Skb2120/Phase-1-project/report/prototype-p_1.jpg

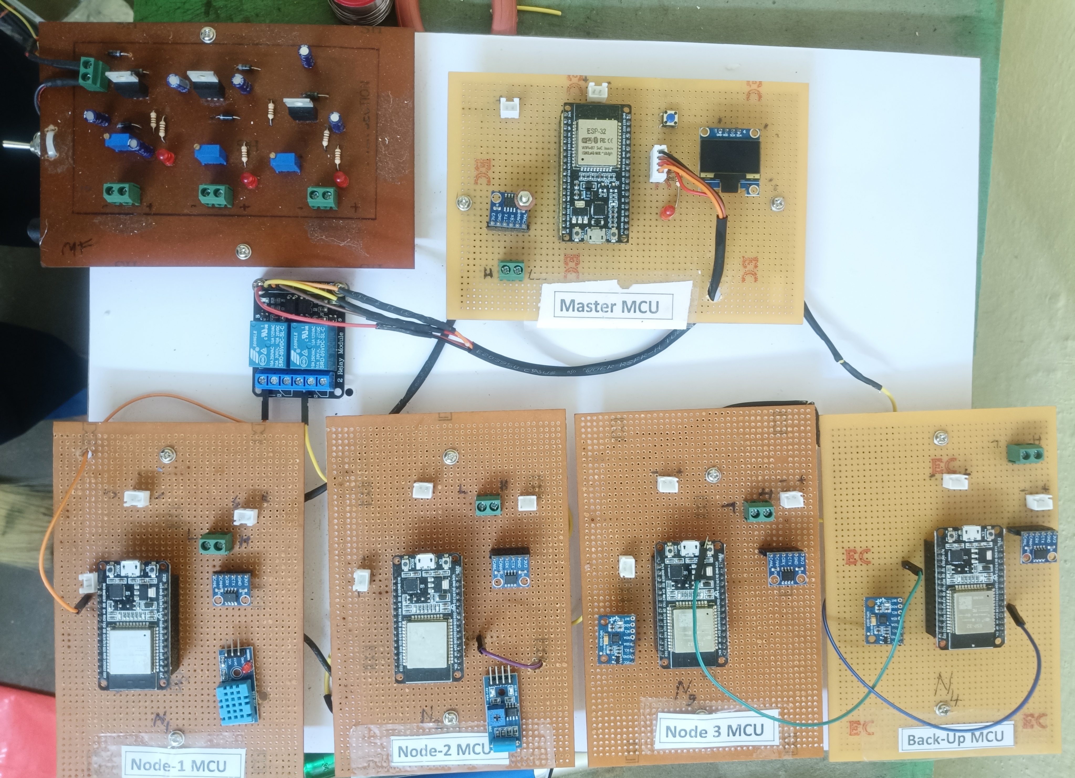
report/prototype-p_1.jpg
