Skb2120/Phase-1-project/report/report fornt page format.docx

CAN-Based Multi-Node ESP32 System for Fault Detection and Autonomous Task Reallocation to a Backup Node with IoT Dashboard Monitoring

Phase - 1 Project Report

Submitted by

Sarathkumar B (411725401001)

in partial fulfillment for the award of the degree of

MASTERS OF ENGINEERING IN

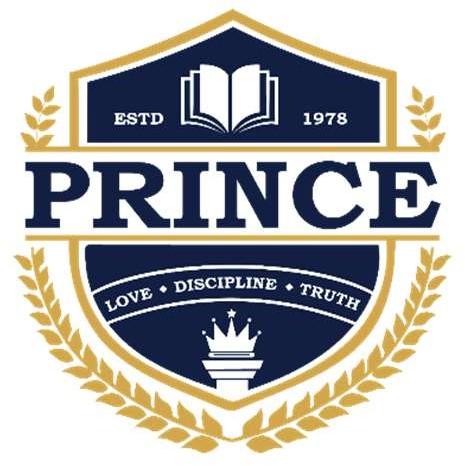
[picture p2: figure]

APPLIED ELECTRONICS

PRINCE SHRI VENKATESHWARA PADMAVATHY ENGINEERING COLLEGE

[AN AUTONOMOUS INSTITUTION], PONMAR, CHENNAI-127

ANNA UNIVERSITY: CHENNAI - 600025

OCTERBER 2026

BONAFIDE CERTIFICATE

Certified that this Phase-1 Project report “CAN-Based Multi-Node ESP32 System for Fault Detection and Autonomous Task Reallocation to a Backup Node with IoT Dashboard Monitoring” is the bonafide work of “Sarathkumar B (411725401001)” who carried out the project under my supervision.

SIGNATURE | SIGNATURE
Dr. K.K. SENTHILKUMAR, M.E., Ph.D., HEAD OF THE DEPARTMENT PROFESSOR Department of ECE, Prince Shri Venkateshwara Padmavathy Engineering College, Ponmar, Chennai- 600 127. | G.VIJAYALAKSHMI , M.E., PROJECT COORDINATOR ASSISTANT PROFESSOR Department of ECE, Prince Shri Venkateshwara Padmavathy EngineeringCollege, Ponmar, Chennai- 600 127.

Submitted for the project Viva-Voce examination held on

INTERNAL EXAMINER EXTERNAL EXAMINER

ACKNOWLEDGEMENT

We express our deep gratitude to our honorable Chairman Dr. K. VASUDEVAN M.A., M.Phil., Ph.D. for rending the technical staffs in completing this project.

We convey our sincere gratitude to our honorable Vice Chairman, Dr. V. VISHNU KARTHIK, M.D.,MBBS for his keen interest in our studies and the facilities offered in the premier institution.

We thank our Dean Dr. V. MAHALAKSHMI, ME., Ph.D., for her valuable guidance and encouragement in all our efforts throughout this course.

We thank our Principal Dr. G. INDIRA, M.E., Ph.D., for her valuable guidance and encouragement in all our efforts throughout this course.

We convey our sincere gratitude to our honorable Head of the Department, coordinator, Dr. K.K. SENTHILKUMAR, M.E., Ph.D., for complete support and constant encouragement without whom this project would not achieved fruition.

We would thank our coordinator, G.VIJAYALAKSHMI, M.E., ASSISTANT PROFESSOR for her constant, encouragement and technical advice.

We also express our deep gratitude to all other faculty members and Lab assistants for their moral support rendered to us.

We could like to express our sincere gratitude to all our family members and friends for their loving support and encouragement.

ABSTRACT

The proposed project presents a CAN communication-based multi-node ESP32 system for fault detection and autonomous task reallocation to a backup node with IoT dashboard monitoring. The system consists of a Master ESP32 and four sensor nodes interconnected through a Controller Area Network (CAN) bus. Node 1 monitors temperature and humidity using a DHT11 sensor, Node 2 detects vibration, and Node 3 performs motion monitoring using an MPU6050 sensor. Node 4 is designed as a universal backup node equipped with a DHT11 sensor, a vibration sensor, and an MPU6050 sensor to support the monitoring tasks of the primary nodes.

The Master ESP32 continuously monitors node health through heartbeat messages and identifies failures based on predefined timeout conditions. When a primary node becomes unavailable, the Master initiates task reassignment to the corresponding backup sensor on Node 4. This mechanism aims to reduce monitoring interruptions and improve system reliability. Sensor readings, node status, CAN communication information, fault events, and backup activation details are transmitted from the Master ESP32 to a cloud database using Wi-Fi and HTTP/HTTPS communication. A React.js web dashboard integrated with Supabase provides centralized visualization of sensor data, node health, fault detection, and recovery events.

The proposed system combines distributed embedded communication, autonomous fault management, sensor redundancy, and cloud-based monitoring in a unified architecture. The prototype is intended to demonstrate the feasibility of dynamic backup task allocation in embedded sensor networks.

Keywords: ESP32, CAN Bus, Fault Detection, Task Reallocation, Universal Backup Node, Embedded Systems, IoT Dashboard, Supabase.

TABLE OF CONTENTS

CHAPTER NO | TABLE OF CONTENTS | PAGE NO
| ABSTRACT | III
| TABLE OF CONTENTS | IV
| LIST OF FIGURE | VI
| LIST OF ABBREVIATIONS AND SYMBOLS | VII
1 | 1.1 Introduction | 1
| 1.2 Objective | 2
2 | Literature Survey | 4
3 | 3.1 Working Principle | 8
| 3.2 System Design | 10
| 3.3 PCB Design Of Power Section | 11
4 | 4.1 Hardware And Software Implementation | 14
| 4.1.1 ESP32 Development Board | 14
| 4.1.2 SN65HVD230 CAN Transceiver Module | 16
| 4.1.3 DHT11 Sensor | 16
| 4.1.4 Vibration Sensor | 17
| 4.1.5 MPU6050 Accelerometer and Gyroscope | 18
| 4.1.6 OLED Display | 18
| 4.1.7 Two-Channel Relay Module | 19
| 4.1.8 Power Supply and Interconnection | 19
| 4.2 Software Implementation | 20
| 4.2.1 Embedded Software Development Environment | 21
| 4.2.2 Sensor Node Firmware Implementation | 21
| 4.2.3 CAN Communication Software | 21
| 4.2.4 Heartbeat Monitoring and Fault Detection | 22
| 4.2.5 Autonomous Task-Reallocation Software | 23
| 4.2.6 Wifi & Cloud Communication | 23
| 4.2.7 Supabase Database Implementation | 24
| 4.2.8 Webdashboard | 24
5 | Result & Discussion | 28
6 | Future Scope & Conclusion | 31
| References | 33

List of Figures

Figure no | List of figure | Page no
Figure 3.2.1 | Block diagram of Architecture master system side | 10
Figure 3.2.2 | Block diagram of Architecture Node system side | 11
Figure 3.3 | PCB Design Voltage regulator | 12
Figure 4.1.1 | ESP32 Development board | 15
Figure 4.1.2 | SN65HVD230 CAN Module | 16
Figure 4.1.3 | DHT 11 sensor | 17
Figure 4,1,4 | Vibration sensor | 17
Figure 4.1.5 | IMU MPU6050 Sensor | 18
Figure 4.1.6 | Oled display | 19
Figure 4.1.7 | Relay 2 Channel Opto coupler Type | 19
Figure 4.2.1 | Web dashboard | 25
Figure 5.1 | Prototype Model | 29

ABBREVIATIONS

S. No. | Abbreviation | Full Form
1 | CAN | Controller Area Network
2 | ESP32 | Espressif Systems 32-bit Microcontroller Series
3 | IoT | Internet of Things
4 | MCU | Microcontroller Unit
5 | GPIO | General-Purpose Input/Output
6 | DHT11 | Digital Temperature and Humidity Sensor (model designation)
7 | MPU6050 | 6-Axis Accelerometer and Gyroscope (device designation)
8 | I²C | Inter-Integrated Circuit
9 | SDA | Serial Data
10 | SCL | Serial Clock
11 | CANH | CAN High
12 | CANL | CAN Low
13 | TWAI | Two-Wire Automotive Interface
14 | IDE | Integrated Development Environment
15 | Wi-Fi | Wireless Networking Technology
16 | HTTP | Hypertext Transfer Protocol
17 | HTTPS | Hypertext Transfer Protocol Secure
18 | API | Application Programming Interface
19 | REST | Representational State Transfer
20 | JSON | JavaScript Object Notation
21 | UI | User Interface
22 | DBMS | Database Management System
23 | SQL | Structured Query Language
24 | PCB | Printed Circuit Board
25 | OLED | Organic Light-Emitting Diode
26 | USB | Universal Serial Bus
27 | IDE | Integrated Development Environment
28 | RLS | Row Level Security
29 | RTOS | Real-Time Operating System
30 | PWM | Pulse-Width Modulation
