Skb2120/Phase-1-project/report/label.docx

Master MCU

Node 3 MCU

Node-1 MCU

Node-2 MCU

Back-Up MCU

CAN-Based Multi-Node ESP32 System for Fault Detection and Autonomous Task Reallocation to a Backup Node with IoT Dashboard Monitoring

Overall project datasheet and pin connections

Project: CAN-Based Multi-Node ESP32 System for Fault Detection and Autonomous Task Reallocation to a Backup Node with IoT Dashboard Monitoring.

This is the consolidated hardware connection plan for your full project using 1 Master ESP32 (38-pin), 4 Sensor ESP32 nodes (30-pin), and 5 SN65HVD230 CAN transceiver modules.

1. System architecture

Master ESP32 — 38-pin

Fault detection · OLED · Wi-Fi

GPIO 5 (TX) / GPIO 4 (RX)

SN65HVD230 #1

CAN transceiver

Shared CANH / CANL bus

Node 1

SN65HVD230 #2

DHT11

Node 2

SN65HVD230 #3

Vibration sensor

Node 3

SN65HVD230 #4

MPU6050

Node 4 — Backup

SN65HVD230 #5

DHT11 + vibration + MPU6050

Master Wi-Fi → Supabase → React dashboard

The wiring below uses proposed GPIO assignments for the classic ESP32. Verify the exact board variant and module labels before powering the system.

2. Master ESP32 pin connections

Master ESP32 pin | Connect to | Function
3V3 | SN65HVD230 #1 VCC | Transceiver power
GND | Transceiver GND and OLED GND | Ground reference
GPIO 5 | Transceiver TXD / D | CAN transmit
GPIO 4 | Transceiver RXD / R | CAN receive
GPIO 21 | OLED SDA | I²C data
GPIO 22 | OLED SCL | I²C clock
GPIO 18 | Relay IN1 (optional) | Relay channel 1
GPIO 19 | Relay IN2 (optional) | Relay channel 2
GPIO 2 | LED through resistor (optional) | Status indicator
GPIO 23 | Push-button to GND (optional) | Reset/recovery request

The ESP32's built-in TWAI controller implements CAN protocol handling, while the SN65HVD230 handles the electrical CAN bus signals.

Espressif Documentation

+1

3. All four sensor nodes

Node 1 — DHT11

DHT11 pin | ESP32 Node 1
VCC | 3.3 V, if supported by the module
GND | GND
DATA | GPIO 16

Node 2 — vibration sensor

Sensor pin | ESP32 Node 2
VCC | Module-rated supply
GND | GND
DO | GPIO 17
AO (if available) | ADC-capable GPIO, optional

Node 3 — MPU6050

MPU6050 pin | ESP32 Node 3
VCC | Supply supported by the breakout
GND | GND
SDA | GPIO 21
SCL | GPIO 22
INT (optional) | GPIO 27

Node 4 — universal backup node

Component signal | ESP32 Node 4
DHT11 DATA | GPIO 16
Vibration sensor DO | GPIO 17
MPU6050 SDA | GPIO 21
MPU6050 SCL | GPIO 22
MPU6050 INT (optional) | GPIO 27
All sensor grounds | GND

Node 4 uses its own sensors and local I²C bus. Its MPU6050 connections must not be wired to Node 3's I²C bus.

4. SN65HVD230 module connections — repeat five times

The official TI IC datasheet identifies the following pins.

Texas Instruments

IC pin | Signal | Connection
1 | D / TXD | ESP32 GPIO 5
2 | GND | ESP32 GND
3 | VCC | ESP32 3V3
4 | R / RXD | ESP32 GPIO 4
5 | Vref | Leave unconnected
6 | CANL | Shared CANL
7 | CANH | Shared CANH
8 | RS | GND for high-speed mode

Repeat this for the Master, Node 1, Node 2, Node 3 and Node 4. If your module has different printed header labels or onboard components, follow its specific module schematic rather than assuming the IC pin numbers match the header order.

5. Complete CAN bus and termination

120 Ω resistor

At first physical end, across CANH–CANL

CANH / CANL twisted-pair trunk

Master

Module #1

Nodes 1–2

Modules #2–3

Nodes 3–4

Modules #4–5

120 Ω resistor

At opposite physical end, across CANH–CANL

- Connect every CANH terminal to the same CANH trunk and every CANL terminal to the same CANL trunk.
- Use only two 120 Ω termination resistors, one at each physical end. Check whether your modules already contain termination resistors.
- With power off and both terminators installed, approximately 60 Ω measured between CANH and CANL is a useful initial check.
- Start testing with two boards before connecting all five.

6. Power supply and common ground

Item | Connection requirement
Master and four nodes | Each powered from a suitable regulated supply or USB
SN65HVD230 modules | 3.3 V supply
Sensor modules | Their individual specified supply voltage
CAN bus | CANH and CANL signal wires
Ground | Common reference for non-isolated prototype electronics

Do not apply 12 V directly to ESP32 GPIOs, sensor signal pins, or SN65HVD230 VCC.

1. CAN module pin connections for every ESP32

SN65HVD230 module pin | Master ESP32 | Node 1 | Node 2 | Node 3 | Node 4
VCC | 3V3 | 3V3 | 3V3 | 3V3 | 3V3
GND | GND | GND | GND | GND | GND
TXD / D | GPIO 5 | GPIO 5 | GPIO 5 | GPIO 5 | GPIO 5
RXD / R | GPIO 4 | GPIO 4 | GPIO 4 | GPIO 4 | GPIO 4
CANH | Shared CANH | Shared CANH | Shared CANH | Shared CANH | Shared CANH
CANL | Shared CANL | Shared CANL | Shared CANL | Shared CANL | Shared CANL
RS, if exposed | GND* | GND* | GND* | GND* | GND*
Vref, if exposed | Leave open | Leave open | Leave open | Leave open | Leave open
