Skb2120/Phase-1-project/P_1_project/mirror.pdf

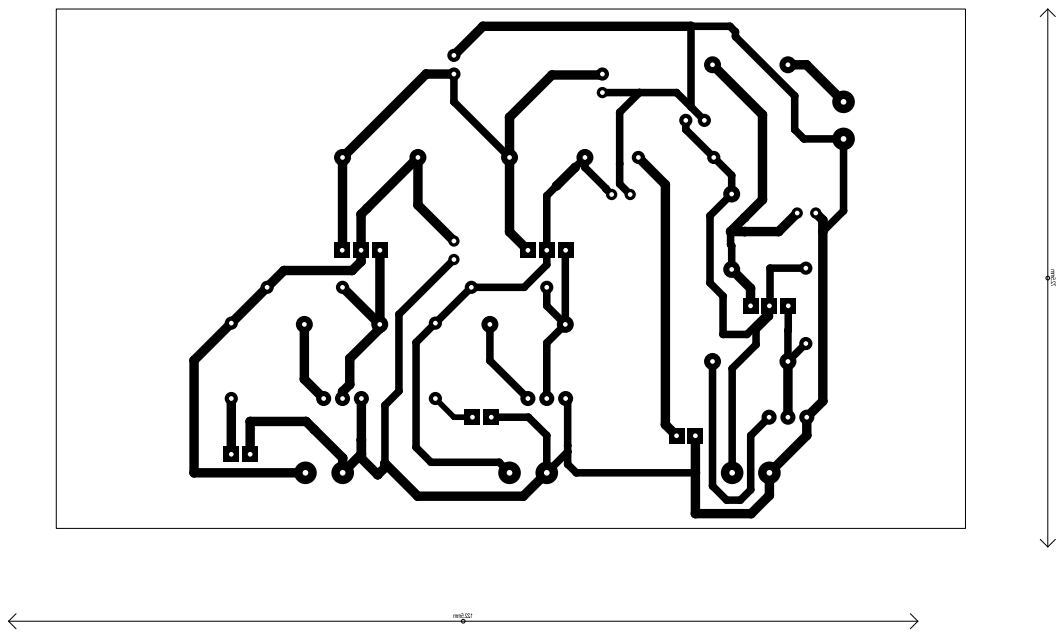
[picture p26: page 1]

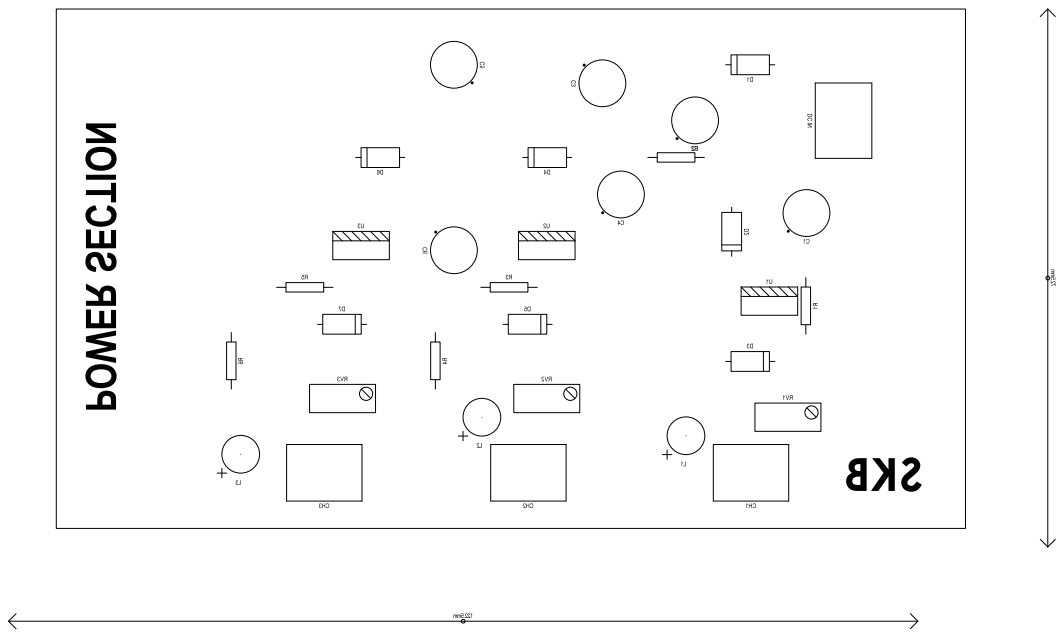
[picture p27: page 2]

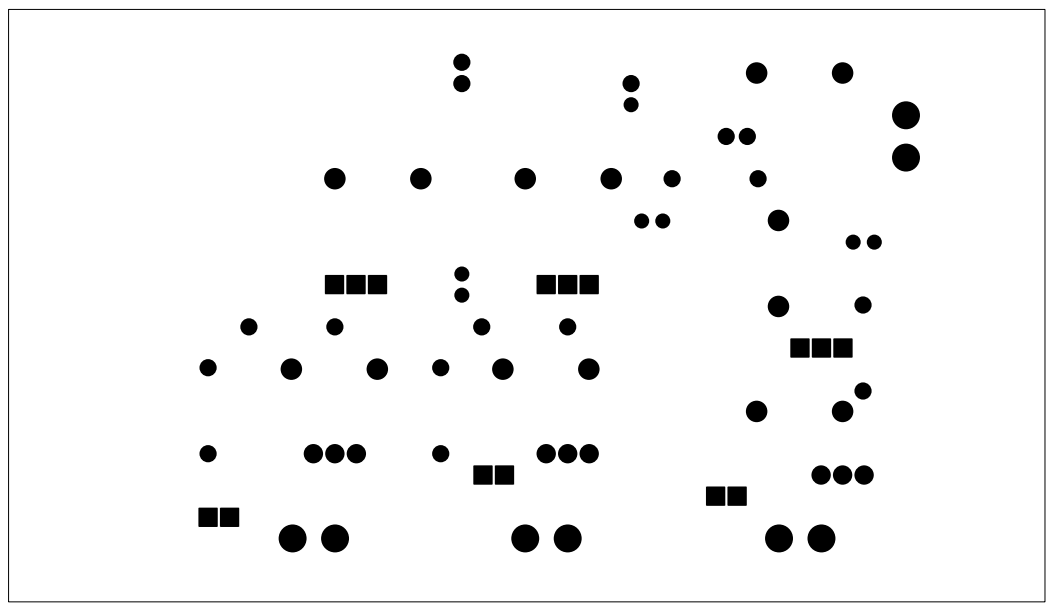
[picture p28: page 3]

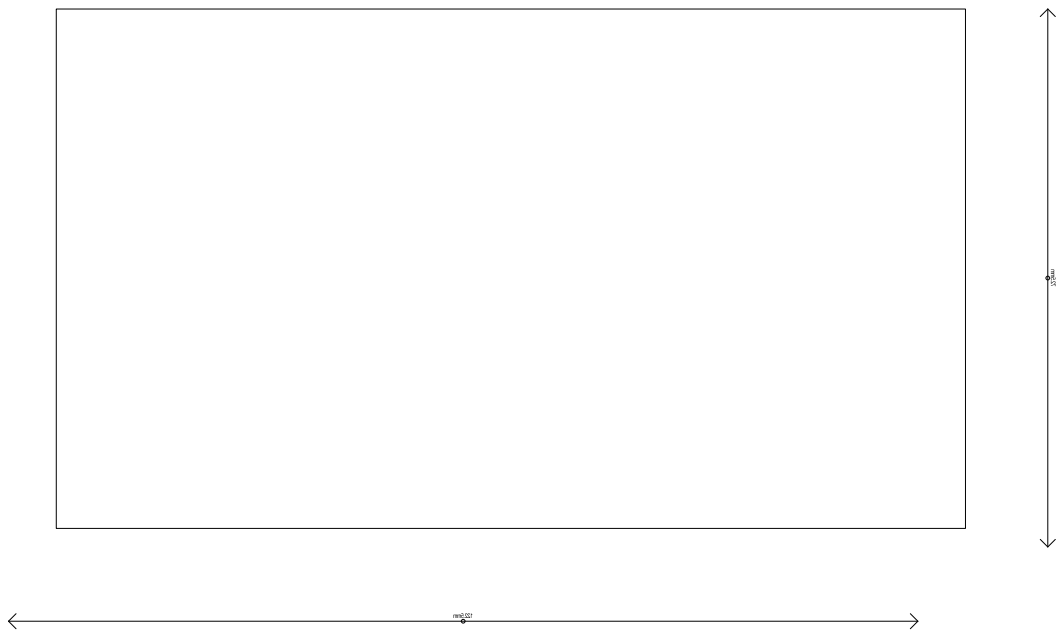
[picture p29: page 5]
