Skb2120/Phase-1-project/P_1_project/normal.pdf

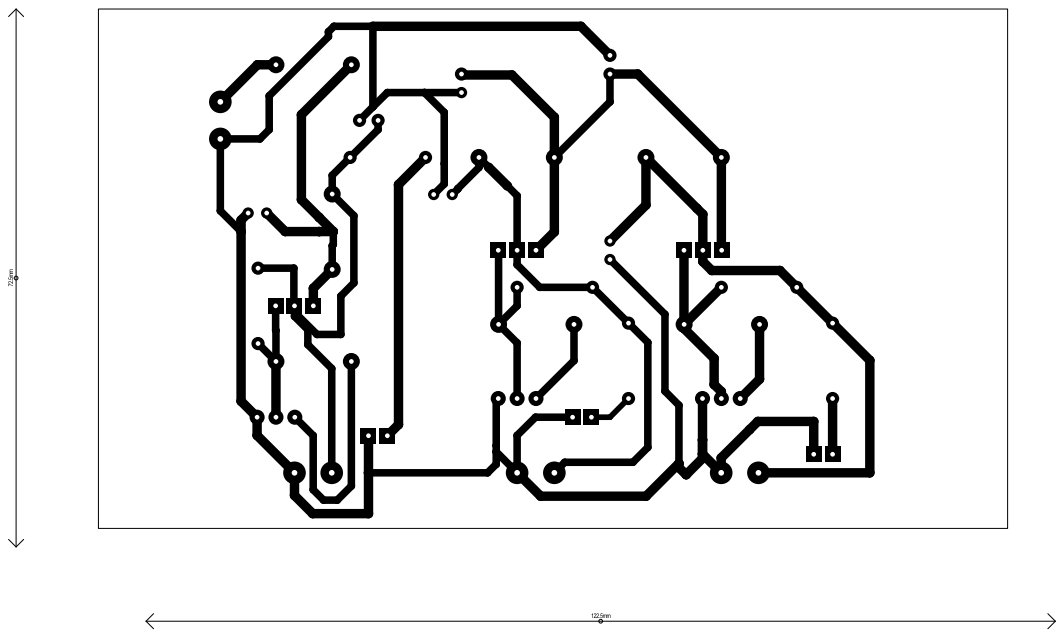
[picture p30: page 1]

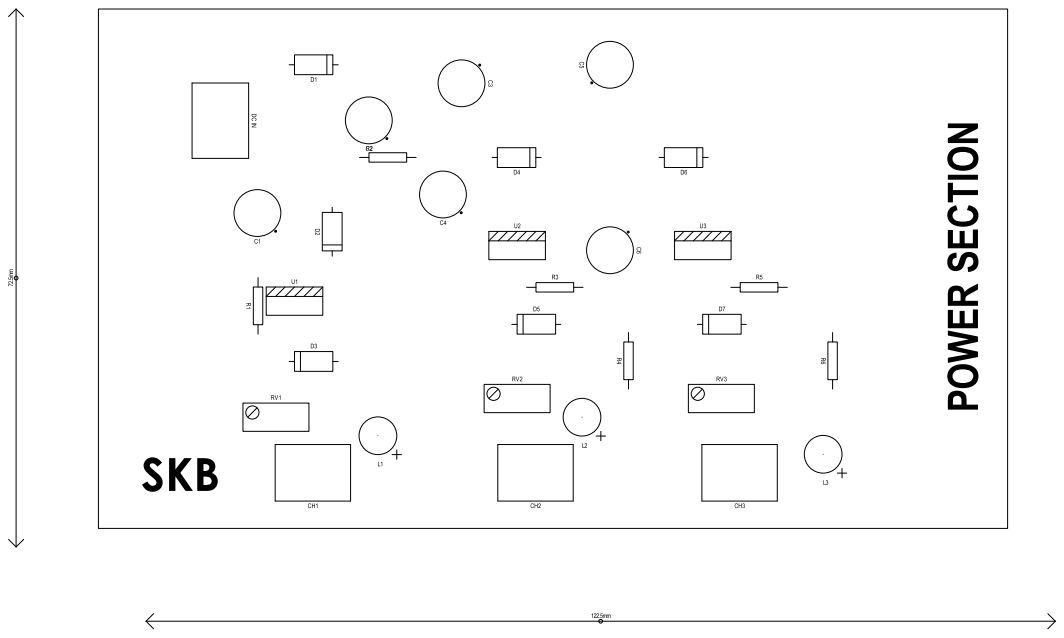
[picture p31: page 2]

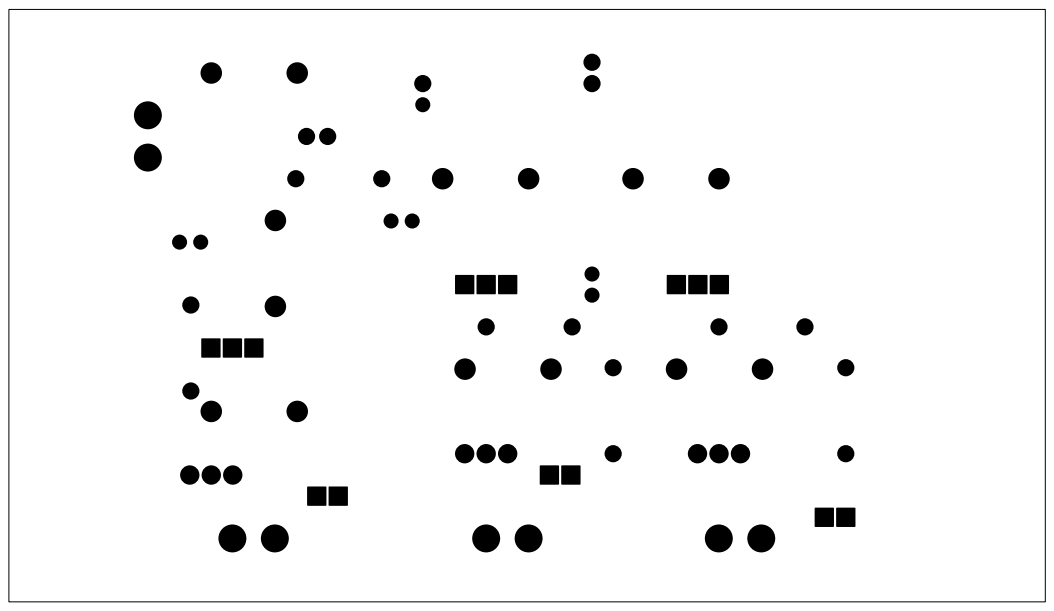
[picture p32: page 3]

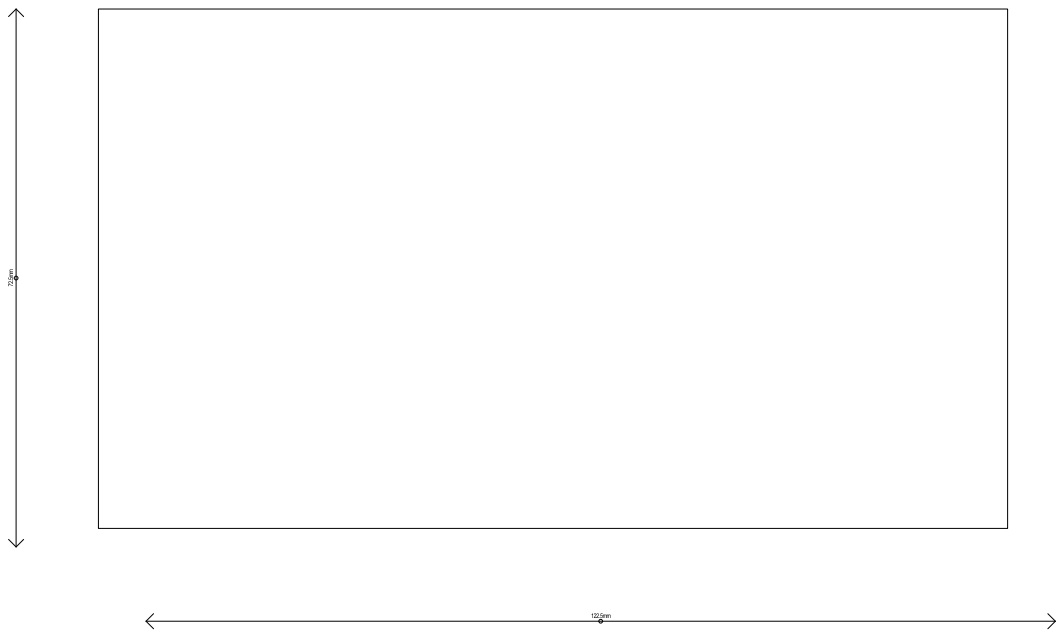
[picture p33: page 5]
