Skb2120/Phase-1-project/(list of files, drawings)

Other design files:
P_1_project/Buck.pdsprj
P_1_project/Project Backups/Buck [20260928, 13-42-20].pdsprj
P_1_project/Project Backups/Buck [20260929, 12-33-57].pdsprj
P_1_project/Project Backups/Buck [20260929, 20-16-22].pdsprj
P_1_project/Project Backups/Buck [20260929, 20-40-29].pdsprj
P_1_project/Project Backups/Buck [20261003, 18-04-50].pdsprj
P_1_project/Project Backups/Buck [20261003, 18-26-15].pdsprj
P_1_project/Project Backups/Buck [20261003, 18-36-04].pdsprj
P_1_project/Project Backups/Buck [20261003, 18-41-00].pdsprj
P_1_project/Project Backups/Buck [20261005, 09-13-49].pdsprj
P_1_project/Project Backups/Buck [20261007, 20-12-23].pdsprj
